thomasblankschein/fbh-monitor/docs/bilder/balkenclip.jpg

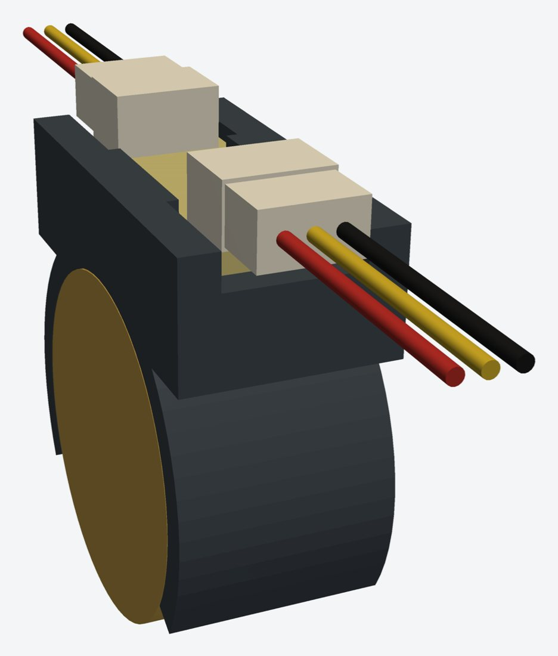
docs/bilder/balkenclip.jpg
