thomasblankschein/fbh-monitor/docs/bilder/basisplatine.jpg

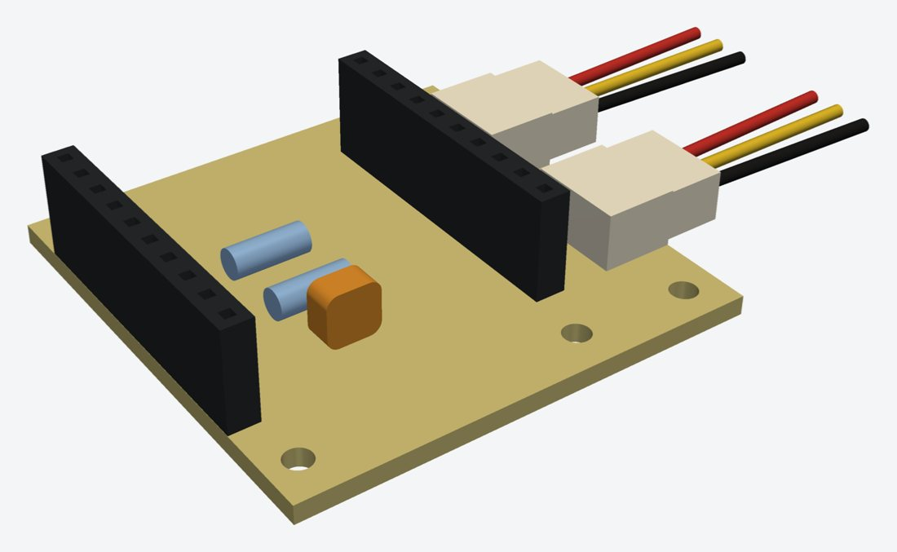
docs/bilder/basisplatine.jpg
