thomasblankschein/fbh-monitor/docs/bilder/druckbett.jpg

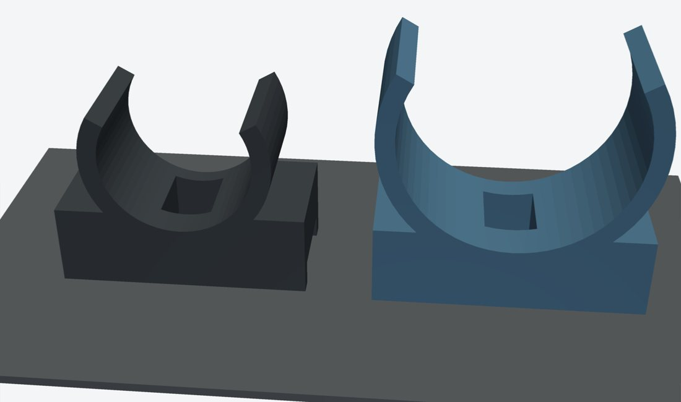
docs/bilder/druckbett.jpg
