thomasblankschein/fbh-monitor/docs/bilder/fuehlerknoten_unten.jpg

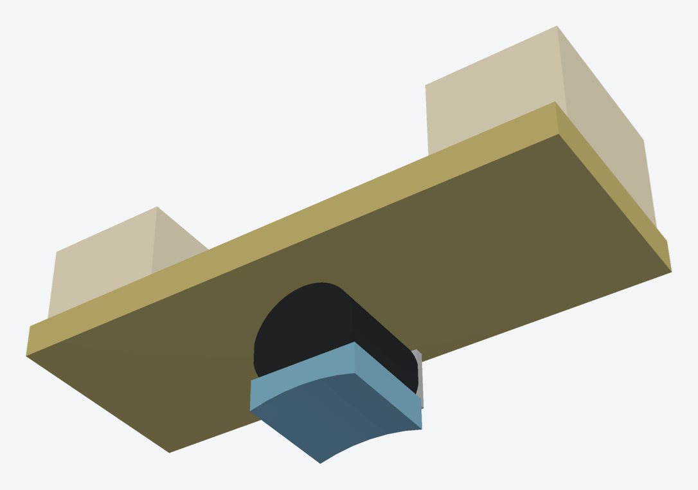
docs/bilder/fuehlerknoten_unten.jpg
