thomasblankschein/fbh-monitor/docs/bilder/kette.jpg

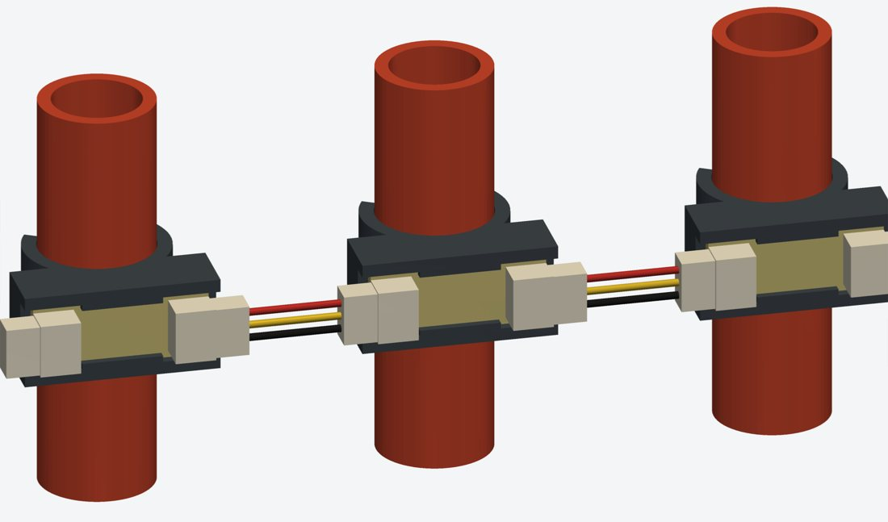
docs/bilder/kette.jpg
