thomasblankschein/fbh-monitor/docs/bilder/rohrclip_mit_knoten.jpg

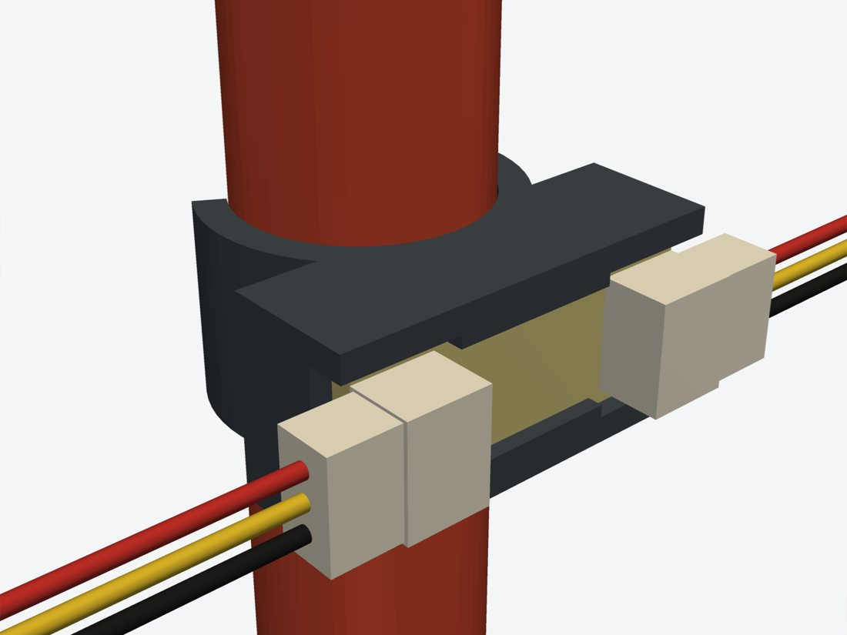
docs/bilder/rohrclip_mit_knoten.jpg
