thomasblankschein/fbh-monitor/docs/bilder/rohrclip_stirnseite.jpg

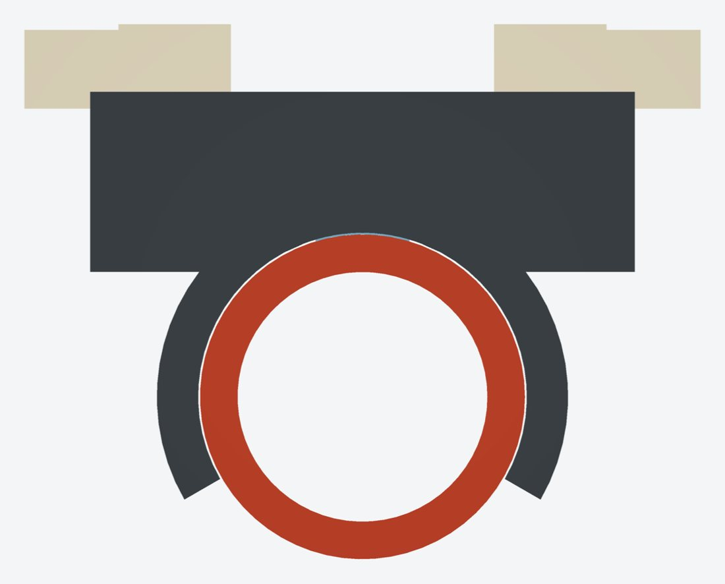
docs/bilder/rohrclip_stirnseite.jpg
