thomasblankschein/fbh-monitor/bestellung/digikey_warenkorb.csv

Menge | Digi-Key-Teilenummer | Hersteller-Teilenummer | Kundenreferenz
3 | 1188-ESP32-POE-ISO-ND | ESP32-POE-ISO | FBH Modul (2 + 1 Reserve/Test)
4 | 35-PRPC010SAAN-RC-ND | PRPC010SAAN-RC | FBH Stiftleiste 1x10
70 | 455-1720-ND | S3B-PH-K-S(LF)(SN) | FBH JST-PH Buchse gewinkelt
70 | 455-1126-ND | PHR-3 | FBH JST-PH Gehaeuse
200 | 455-2148-100-ND | SPH-002T-P0.5L | FBH Crimpkontakte (Streifen a 100)
