thomasblankschein/fbh-monitor/cad/export/modul_baugruppe.step

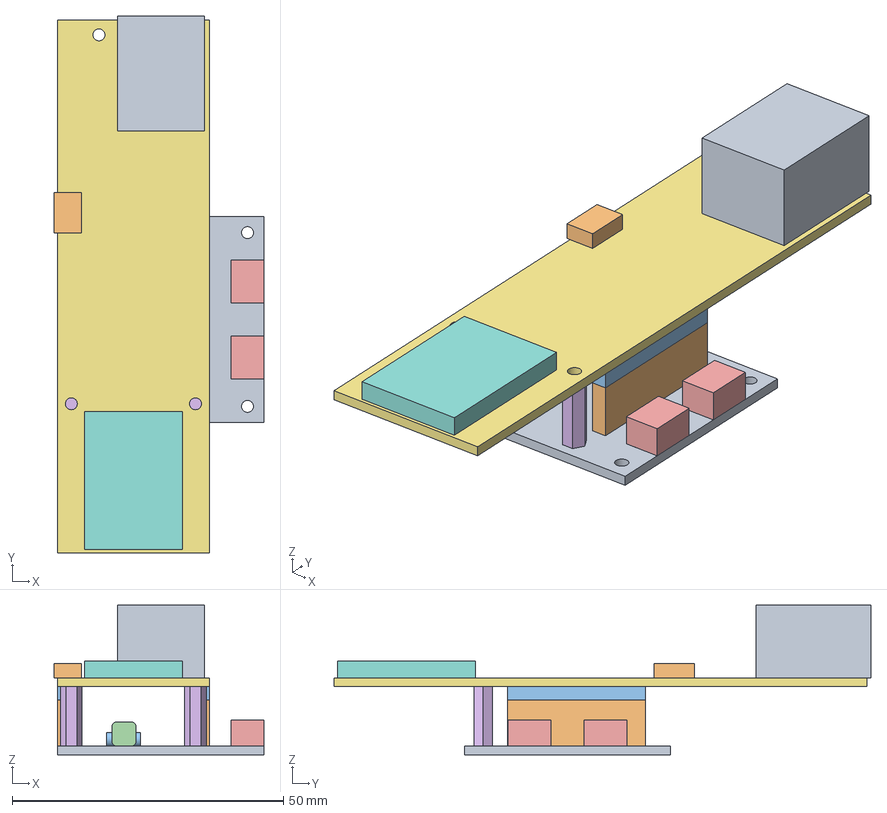
[picture p10: CAD file, 2026-10-25]
cad/export/modul_baugruppe.step
38.6 x 98.9 x 27.6 mm
