thomasblankschein/fbh-monitor/cad/export/fuehlerknoten.step

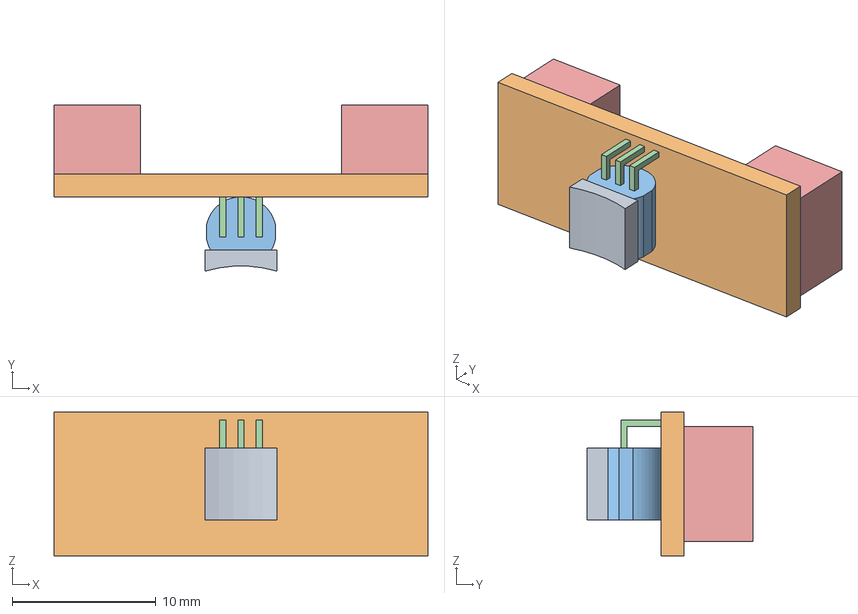
[picture p11: CAD file, 2026-10-25]
cad/export/fuehlerknoten.step
26.0 x 11.6 x 10.0 mm
