thomasblankschein/fbh-monitor/cad/export/rohrclip_balken_D26_7_druck.stl

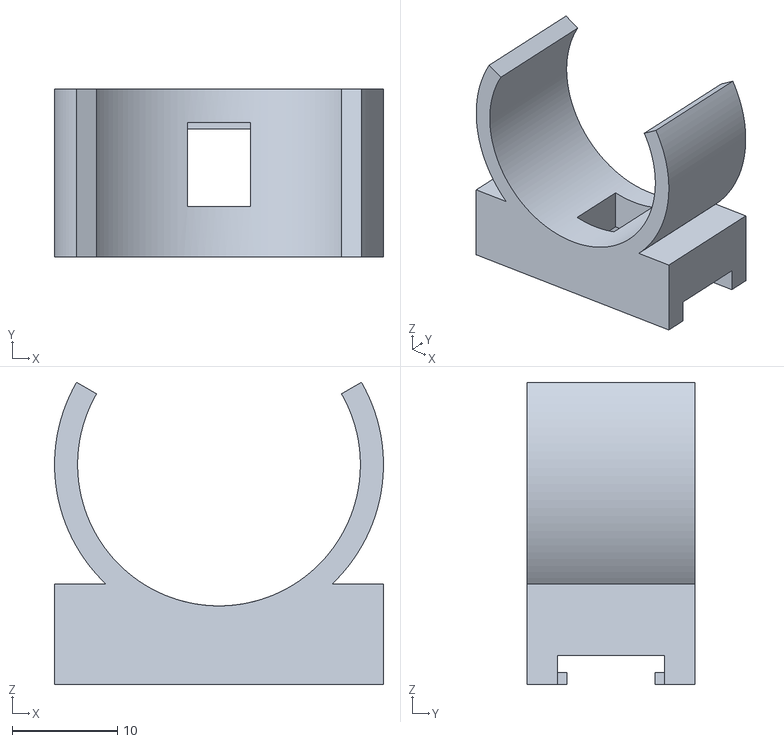
[picture p12: CAD file, 2026-10-25]
cad/export/rohrclip_balken_D26_7_druck.stl
31.3 x 16.0 x 28.8
