thomasblankschein/fbh-monitor/cad/export/rohrclip_abgang_D17_3.step

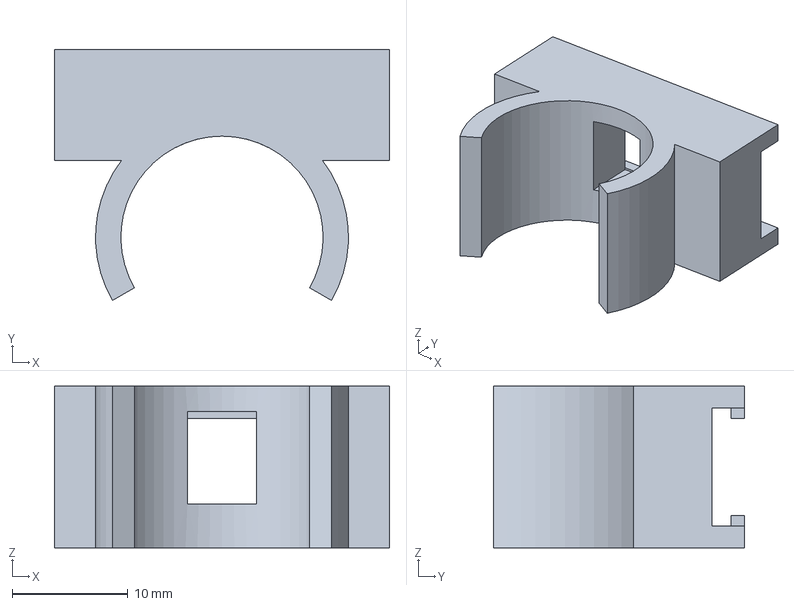
[picture p13: CAD file, 2026-10-25]
cad/export/rohrclip_abgang_D17_3.step
29.0 x 21.7 x 14.0 mm
