thomasblankschein/fbh-monitor/cad/export/distanzhuelse_11mm.stl

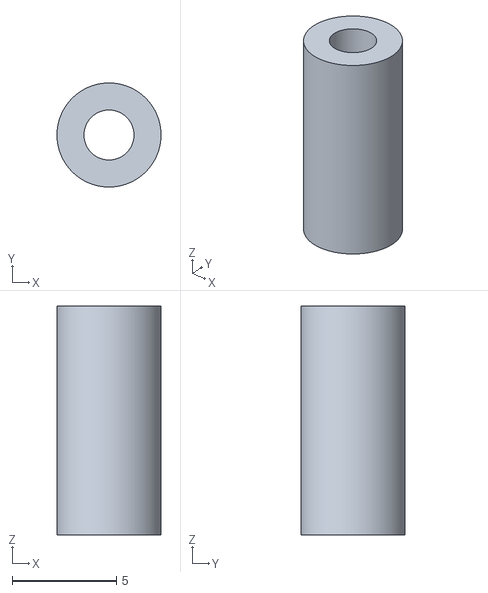
[picture p14: CAD file, 2026-10-25]
cad/export/distanzhuelse_11mm.stl
5.00 x 5.00 x 11.0
