thomasblankschein/fbh-monitor/(list of files, cad)

Other CAD files:
cad/export/rohrclip_balken_D26_7.step
cad/export/rohrclip_abgang_D17_3_druck.stl
