thomasblankschein/fbh-monitor/docs/bauanleitung.html

Maker-Projekt · KiCad · FreeCAD · ESPHome · Home Assistant

# FBH-Monitor

Vor- und Rücklauftemperatur jedes Fußbodenheizkreises messen und daraus erkennen, ob der Kreis durchflossen wird. Eigene Platinen, gedruckte Rohrclips und ein kompaktes Gehäuse pro Verteiler, versorgt über PoE.

Verteiler

EG + OG

Fühlerknoten je Verteiler

15

Gehäuse außen

≈ 44 × 104 × 36 mm

Versorgung

PoE 802.3af

## Konzept

Alles Aufwendige liefert das fertige Board: Ethernet, PoE mit galvanischer Trennung und den ESP32. Selbst gebaut werden nur einfache, einseitige Platinen, die sich gut ätzen oder fräsen lassen, sowie die Druckteile.

Basisplatine

38 × 38 mm, einseitig. Das Olimex ESP32-POE-ISO steckt über seine Steckleisten EXT1/EXT2 kopfüber auf ihr. Sie trägt die Pull-ups und zwei Buchsen für die Fühlerketten.

Fühlerknoten

10 × 26 mm, einseitig, sitzt direkt im Rohrclip. Ein DS18B20 im TO-92-Gehäuse und an beiden Enden eine gewinkelte JST-PH-Buchse, die Kabel laufen quer zum Rohr zum nächsten Knoten.

Kettenverkabelung

Statt 15 Kabeln sternförmig zum Gehäuse laufen zwei kurze Ketten am Verteiler entlang. Das spart Platz im Kasten und ist für 1-Wire die elektrisch bessere Topologie.

Rohrclips

Gedruckt aus PETG oder ASA, parametrisch für den Rohrdurchmesser. Sie drücken den Fühler mit Wärmeleitpaste ans Rohr und nehmen den Knoten auf.

Gehäuse

Gedruckt, konstruiert um die STEP-Daten des Olimex-Boards. Befestigung auf Hutschiene oder mit Kabelbindern an der Verteilerkonsole.

Eine komplett eigene Platine mit ESP32, Ethernet-PHY und PoE-Teil lohnt sich zum Selbstätzen nicht. Der PHY-Baustein sitzt im QFN-Gehäuse mit 0,5 mm Raster, die RMII-Leitungen laufen mit 50 MHz und das PoE-Netzteil braucht eine Trennung von 1500 V. Das gelingt zuverlässig nur mit gefertigten Mehrlagenplatinen.

## Ansichten

Gerendert aus den CAD-Modellen im Ordner cad. Das Olimex-Board ist vereinfacht: Umriss, Löcher, Steckleisten, Funkmodul, RJ45 und USB sitzen an den Positionen aus dem Olimex-Layout, kleine Bauteile fehlen.

Olimex-Board kopfüber auf der Basisplatine gesteckt, an der Seite zwei JST-Stecker mit Kabeln

R1 Modul: Olimex auf der Basisplatine, rechts die Ketten A und B.

Basisplatine mit zwei Buchsenleisten, zwei Widerständen, Kondensator und zwei gewinkelten JST-Buchsen

R2 Basisplatine 38 × 38 mm mit gesteckten Ketten.

Seitenansicht des Stapels aus Basisplatine, Steckleisten und Olimex-Board

R3 Seitenansicht: 11 mm Abstand zwischen den Platinen, eine gedruckte Distanzhülse pro Olimex-Loch.

Fühlerknoten von unten mit TO-92 und blauem Wärmeleitpad

R4 Fühlerknoten von unten: TO-92 mit dem Rücken an der Platine, darunter das Wärmeleitpad.

Schnitt durch Clip, Rohr, Wärmeleitpad, TO-92 und Platine

R5 Schnitt in Rohrmitte: Rohr, Pad (blau), TO-92, Knotenplatine. Die Rastnasen drücken die Platine nach unten und das Pad zusammen.

Rohrclip auf rotem Heizungsrohr mit eingesetztem Fühlerknoten und Kabeln

R6 Abgangsclip auf Rohr Ø 17,3 mm mit eingerastetem Knoten.

Rohrclip in Blickrichtung des Rohrs mit Öffnung nach unten

R7 Blick entlang des Rohrs: 120° Öffnung, der Clip wird etwa 1 mm je Seite aufgebogen.

Balkenclip auf dem runden Abschnitt des Vorlaufbalkens

R8 Balkenclip auf dem runden Abschnitt Ø 26,7 mm, volle 16 mm breit.

Beide Clips mit der Rastnasen-Seite nach unten auf dem Druckbett

R9 Druckausrichtung: Rastnasen-Seite aufs Bett, kein Stützmaterial nötig.

Drei Rohre im Abstand 50 mm mit Clips, Knoten und verbindenden Kabeln

R10 Kette an drei Rohren im Abstand 50 mm. Zwischen zwei Steckern bleiben nur etwa 14 mm, die Segmentkabel brauchen daher eine kleine Schlaufe.

## Systemübersicht

Abb. 1 Topologie. Jeder Verteiler ist ein eigenes ESPHome-Gerät mit identischer Hardware.

## Fühlerketten am Verteiler

Kette A beginnt am Referenzfühler auf dem Vorlaufbalken und läuft dann über alle Vorläufe. Kette B läuft über alle Rückläufe. Zwischen zwei Knoten liegt ein kurzes Kabel, etwas länger als der Abstand der Abgänge (meist 50 mm, bitte nachmessen).

Abb. 2 Kette A (rot, 8 Knoten) und Kette B (blau, 7 Knoten). Jeder Knoten sitzt in einem Rohrclip.

- Vorlauf: Knoten 3–5 cm unterhalb der Verschraubung. Näher am Messing würde die Wärme vom Balken einen geschlossenen Kreis warm erscheinen lassen.
- Rücklauf: direkt unter der Verschraubung. Dort gibt es diesen Effekt nicht, also gilt hier: möglichst nah am Verteiler.
- Die Reihenfolge in der Kette spielt für die Software keine Rolle, jeder Fühler wird über seine eindeutige Adresse angesprochen.

### Kettenverkabelung

Variante | Aufbau | Bewertung
JST-PH-Segmenteempfohlen | Je Knoten zwei gewinkelte Buchsen. Zwischen zwei Knoten ein Kabel mit zwei PHR-3-Steckern, Pins 1:1 durchverbunden. | Flach, verriegelnd, jedes Segment einzeln tauschbar. Braucht eine Crimpzange oder fertige Kabel.
Flachband mit Schneidklemmen | Ein durchgehendes 6-adriges Flachbandkabel je Kette. An jeder Knotenposition wird ein 2 × 3-Pfostenstecker aufgepresst, auf dem Knoten sitzt ein Wannenstecker. | Kein Crimpen, ein Kabel pro Kette. Der Knoten wird aber gut 10 mm höher und die Steckerpositionen sind nach dem Pressen fest.
Direkt verlötet | Litze direkt auf Lötpads der Knoten. | Am kleinsten, aber nicht wartbar. Ein defekter Fühler bedeutet Lötarbeit am Verteiler.

- Segmentlänge: etwa 80 mm bei 50 mm Abgangsabstand. Die Schlaufe gleicht Toleranzen aus und lässt sich unter das Armaflex-Band legen.
- Zuleitung: vom Modul zum ersten Knoten jeder Kette nach Bedarf, typisch 30–60 cm.
- Kettenende: Die freie Buchse am letzten Knoten bleibt einfach offen, ein Abschlusswiderstand ist nicht nötig.

Jedes Kabel vor dem Einstecken mit dem Multimeter prüfen: Pin 1 muss auf Pin 1 gehen. Fertige JST-Kabel werden oft gedreht verkauft. Ein gedrehtes Kabel vertauscht GND und VDD, das zerstört den Fühler.

## Schaltplan Basisplatine

Abb. 3 Basisplatine. Pinbelegung von EXT1/EXT2 aus dem KiCad-Layout von Olimex (Rev. O) übernommen.

- Die Pin-Reihenfolge 1 GND · 2 DQ · 3 VDD gilt an allen Buchsen und entspricht der Belegung des DS18B20 im TO-92-Gehäuse. Leiterbahnen laufen dadurch auf allen Platinen gerade durch.
- 4,7 kΩ reichen bei zwei kurzen Ketten unter 2 m. Falls einzelne Fühler sporadisch fehlen, auf 2,2 kΩ wechseln.
- Optional pro Kette ein Footprint für eine ESD-Schutzdiode (z. B. SOD-323) zwischen DQ und GND vorsehen, bestückt wird sie nur bei Bedarf.

## Mechanik Basisplatine

Olimex sieht die Steckleisten EXT1/EXT2 auf der Unterseite vor. Stiftleisten werden also von oben eingesteckt und unten herausstehend verlötet. Das Board steckt dann mit der Bauteilseite nach oben in die Buchsenleisten der Basisplatine.

Abb. 4 Maße in mm, bezogen auf das Antennenende des Olimex-Boards. Roter Punkt = Pin 1. Löcher: Olimex Ø 2,2 mm, Basisplatine für M2.

Steckleisten

EXT1 1,29 mm von der linken Kante, EXT2 1,31 mm von der rechten Kante, Abstand 25,40 mm. Pin 1 liegt 33,22 mm vom Antennenende, Pin 10 bei 56,08 mm.

Montagelöcher Olimex

Zwei Löcher Ø 2,2 mm bei 27,48 mm vom Antennenende, 2,56 mm von links und 2,58 mm von rechts. Diese übernimmt die Basisplatine, verbunden wird mit M2-Schraube und gedruckter Distanzhülse. Ein drittes Loch sitzt beim RJ45 (7,64 / 95,42 mm) und stützt das Board im Gehäuse.

Basisplatine

38 × 38 mm, Längsbereich 24–62 mm. Rechts 10 mm Überstand für J1 und J2, die Kabel gehen seitlich heraus. Zwei weitere M2-Löcher zur Befestigung im Gehäuse.

Bauhöhe

Mit Standard-Buchsenleisten (8,5 mm) etwa 11 mm Abstand zwischen den Platinen. Auf der Olimex-Unterseite sitzen dort nur flache Bauteile, das höchste ist eine Diode mit 2,3 mm.

Das Board gibt es auch als WROVER-Variante. Dort liegt der Ethernet-Takt auf GPIO0 statt GPIO17, und GPIO33 ist belegt. Für dieses Konzept unbedingt die WROOM-Variante kaufen.

## Fühlerknoten und Rohrclip

Abb. 5 Fühlerknoten. Links Schaltplan, Mitte Platine, rechts schematischer Querschnitt: Clip auf dem Rohr, darüber der Knoten, außen herum Armaflex-Band. Die genaue Form zeigen R5 bis R7.

Clip

C-Form mit 120° Öffnung, 2,2 mm Wandstärke, 0,1 mm radiales Spiel, 14 mm lang (Balken 16 mm). Zwei Varianten nach deinen Maßen: Abgang Ø 17,3 mm (29 × 22 × 14 mm, etwa 4,3 g) und Balken Ø 26,7 mm (31 × 29 × 16 mm, etwa 6 g).

Druck

Mit der Rastnasen-Seite aufs Bett legen, so sind die STL-Dateien bereits ausgerichtet. Ohne Stützmaterial, Brim empfohlen, weil die Auflagefläche klein ist. Erst einen Clip testen: Sitzt er zu stramm, im Skript das Spiel auf 0,2 mm erhöhen.

Aufnahme

Zwei Wände mit Rastnasen halten die Knotenplatine. Die Nasen drücken die Platine nach unten, die Platine drückt den TO-92 und der TO-92 das Pad durch ein Fenster im Sattel auf das Rohr. Ein Deckel ist nicht nötig. Die Kabel gehen quer zum Rohr seitlich heraus.

Wärmeübergang

Silikon-Wärmeleitpad 1,5 mm, 5 × 5 mm, weich (Shore 00 ≤ 50), 3–6 W/mK. Der Clip ist so bemessen, dass das Pad am Rohrscheitel auf 1,1 mm zusammengedrückt wird (etwa 27 %). An den Rändern des Sensors bleibt es durch die Rohrkrümmung noch leicht angedrückt. Das Pad gleicht Toleranzen von Druck und Rohr aus und ist zugleich die Feder für den Anpressdruck.

Befestigung TO-92

Der Rücken des TO-92 liegt direkt an der Platinenunterseite und wird mit einem Tropfen 2K-Epoxid fixiert. Die Anpresskraft geht so über den Sensorkörper, nicht über die Lötstellen.

Variante Balken

Sitzt auf dem runden Abschnitt (Ø 26,7 mm, 16 mm breit). Die Kabel laufen quer zur Balkenachse, also bei waagerechtem Balken nach oben und unten.

Material

PETG oder ASA. PLA wird im warmen Verteilerkasten auf Dauer weich und verliert die Klemmkraft.

## Gehäuse

Innenmaß

etwa 40 × 100 × 32 mm, außen etwa 44 × 104 × 36 mm bei 2 mm Wandstärke.

Öffnungen

RJ45 an der Stirnseite, Micro-USB an der linken Längsseite (nur zum ersten Flashen), J1 und J2 an der rechten Längsseite.

Befestigung

Basisplatine mit zwei M2-Schrauben auf Domen im Boden. Olimex mit M2-Schrauben und Distanzhülsen auf der Basisplatine, zusätzlich eine Stütze unter dem Loch beim RJ45, damit beim Einstecken des Patchkabels nichts auf die Steckleisten drückt.

Montage

Hutschienen-Rastfuß (TS35) oder zwei Schlitze für Kabelbinder an der Verteilerkonsole.

Wärme

Das Modul nimmt unter 2 W auf. Ein paar Lüftungsschlitze im Deckel genügen.

Am genauesten wird das Gehäuse, wenn du Olimex' KiCad-Dateien (GitHub, Ordner HARDWARE, Rev. O) öffnest, daraus ein STEP-Modell exportierst und dieses in FreeCAD als Referenz einsetzt. So stimmen RJ45, USB und Löcher ohne Nachmessen.

## Fertigungshinweise KiCad

- Beide Platinen einseitig, Kupfer unten. Leiterbahnen mindestens 0,6 mm, Abstände mindestens 0,4 mm. Das ist zum Ätzen und Fräsen unkritisch.
- Pads für Steckverbinder mindestens 1,8 mm Durchmesser, Bohrungen 0,8 mm für Bauteile und 1,0 mm für Stift- und Buchsenleisten.
- Die Basisplatine hat nur vier Netze und lässt sich ohne Brücken entflechten. Die Lage der Buchsenleisten aus Abb. 4 als Raster mit Ursprung am Antennenende anlegen.
- Am Knoten liegt der TO-92 auf der Kupferseite. Die Pads dafür als SMD-Pads (etwa 1,2 × 2,5 mm) anlegen und die gebogenen Beinchen flach auflöten. Der Sensorrücken liegt ohne Spalt an der Platine.
- Ein Nutzen aus 15 Knoten plus Basisplatine braucht etwa 60 × 100 mm. Eine Europakarte reicht für beide Verteiler.
- Nach dem Ätzen Lötstopplack oder Schutzlack aufbringen, weil im Verteilerkasten Kondenswasser auftreten kann.

## Bauteilliste

Mengen pro Verteiler und für beide zusammen, mit etwas Reserve. Die Datei digikey_warenkorb.csv enthält alle Digi-Key-Positionen für beide Verteiler und lässt sich im Digi-Key-Warenkorb hochladen. Eine Crimpzange für JST-PH wird zusätzlich gebraucht.

Bauteil | Hersteller-Nr. und Spezifikation | Digi-Key | je Verteiler | gesamt
Modul
Olimex ESP32-POE-ISO | Olimex ESP32-POE-ISO, WROOM-Variante, nicht „-WROVER“Galvanisch getrennt, darf gleichzeitig an USB und PoE | 1188-ESP32-POE-ISO-ND | 1 | 2
Stiftleiste 1 × 10 | Sullins PRPC010SAAN-RC, 2,54 mm, an Olimex-Unterseite löten | 35-PRPC010SAAN-RC-ND | 2 | 4
Buchsenleiste 1 × 10 | Sullins PPTC101LFBN-RC, 2,54 mm, 8,5 mm hoch | S7008-ND | 2 | 4
Widerstand 4,7 kΩ | Stackpole CF14JT4K70, 1/4 W, bedrahtet 0207 | CF14JT4K70CT-ND | 2 | 4
Kondensator 100 nF | KEMET C1206C104K5RACTU, 1206, X7R, 50 V | 399-C1206C104K5RACTUCT-ND | 1 | 2
JST-PH-Buchse gewinkelt | JST S3B-PH-K-S(LF)(SN), 3-polig | 455-1720-ND | 2 | 4
Distanzhülse | gedruckt, Ø 5 mm, Bohrung 2,4 mm, 11 mm hochDatei distanzhuelse_11mm.stl | – | 2 | 4
Schraube mit Mutter | M2 × 16, Olimex auf Basisplatine | Normteil | 2 | 4
Schraube | M2 × 6, Basisplatine im Gehäuse | Normteil | 2 | 4
Fühlerknoten
Temperaturfühler | Analog Devices DS18B20+, TO-92Beim Distributor kaufen, auf Marktplätzen sind Fälschungen häufig | DS18B20+-ND | 15 + 1 | 32
JST-PH-Buchse gewinkelt | JST S3B-PH-K-S(LF)(SN), 3-polig | 455-1720-ND | 30 | 60
Kondensator 100 nF | KEMET C1206C104K5RACTU, optional | 399-C1206C104K5RACTUCT-ND | 15 | 30
Wärmeleitpad | t-Global TG-A4500-100-100-1.5, 1,5 mm, 4,5 W/mK, Shore 00 50 ± 15Bogen 100 × 100 mm, daraus 5 × 5 mm schneiden | 1168-TG-A4500-100-100-1.5-ND | 15 | 1 Bogen
Kabel
JST-PH-Gehäuse | JST PHR-3, 3-polig | 455-1126-ND | 30 + 4 | 68
Crimpkontakte | JST SPH-002T-P0.5L, AWG 24–28Isolation 0,8–1,5 mm, passend für Alpha Wire 3049 | 455-2148-100-ND | 100 | 200
Litze schwarz, gelb, rot | Einzelader 0,13–0,14 mm² (26 AWG), Außendurchmesser 0,8–1,5 mm, z. B. Alpha Wire 3049Nicht über Digi-Key: dort nur 30-m-Spulen, gebraucht werden etwa 6 m je Farbe | Elektronikhandel | 3 m je Farbe | 6 m je Farbe
Fertigung und Montage
Basismaterial | FR4 einseitig, 1,6 mm, Europakarte 100 × 160 mm | – | – | 1
Filament | PETG oder ASA, Gehäuse, Clips, Distanzhülsen | – | ≈ 80 g | ≈ 160 g
2K-Epoxid | Zum Fixieren des TO-92 an der Platine | – | – | 1
Dämmband | Armaflex-Tape, 3 mm × 50 mm | – | – | 1 Rolle
Patchkabel | Cat 6, 0,5–1 m | – | 1 | 2
PoE-Port | Switch oder Injektor nach IEEE 802.3afPassives PoE funktioniert nicht | – | 1 | 2

Alle Nummern und Mengen wurden am 25.10.2026 im Digi-Key-Warenkorb geprüft, alle Positionen waren sofort lieferbar. Die Crimpkontakte gibt es als Streifen zu 100 Stück, die Kondensatoren sind bei 50 Stück günstiger als bei 35.

Alternativ gibt es alle Teile außer dem Olimex-Board bei reichelt (bestellung/reichelt_warenkorb.csv, etwa 88 € inkl. MwSt. plus Versand). Dort waren am 25.10.2026 nur 37 PHR-3-Gehäuse verfügbar; der Rest muss nachbestellt werden. Die gelbe Litze gibt es nicht als 10-m-Ring, DQ ist dort orange. Das Olimex-Board direkt bei Olimex oder bei Digi-Key bestellen.

## Inbetriebnahme

### Platinen fertigen und bestücken

1. Basisplatine und 15 Knoten ätzen oder fräsen, lackieren, bestücken. Den TO-92 mit dem Rücken an die Platine legen, Beinchen verlöten und mit einem Tropfen Epoxid fixieren. Stiftleisten von oben in EXT1 und EXT2 des Olimex stecken und auf der Unterseite herausstehend verlöten. Vor dem ersten Einschalten 3,3 V gegen GND auf Kurzschluss prüfen.

### Kabel konfektionieren

2. Je Verteiler 13 Segmente von etwa 80 mm und zwei Zuleitungen vom Modul zum ersten Knoten crimpen, Pins 1:1 durchverbunden. Jedes Kabel mit dem Multimeter prüfen.

### Firmware flashen

3. Den Ordner esphome ins ESPHome-Dashboard kopieren, Schlüssel in secrets.yaml eintragen und fbh-eg.yaml erstmals per USB flashen. Danach läuft alles per OTA.

### Adressen auslesen

4. Am Tisch jeweils einen Knoten an J1 stecken und neu starten. Im Log erscheint unter one_wire seine Adresse. Knoten beschriften (z. B. „EG K3 RL“) und die Adresse in die YAML-Datei eintragen.

### Kalibrieren

5. Alle Knoten eines Verteilers in einen Gefrierbeutel legen, Luft herausdrücken und den Beutel 15 Minuten in ein Wasserbad von etwa 35 °C hängen. Dazu alle Knoten zu einer Kette verbinden. Die Abweichung jedes Fühlers vom Mittelwert kommt als vl_offset bzw. rl_offset in die YAML-Datei.

### Montieren

6. Pad mittig auf das Rohr legen, Clip aufschnappen, Knoten unter die Rastnasen drücken und die Ketten stecken. Jeden Clip und je 3 cm Rohr darüber und darunter mit zwei Lagen Armaflex-Band überwickeln.

### Home Assistant einrichten

7. Das Gerät wird automatisch gefunden. Package und Jinja-Datei kopieren, in fbh.jinja die Entitäten der Stellantriebe eintragen und die Konfiguration neu laden.

### Schwellwerte einmessen

8. Zwei bis drei Heiztage die Verläufe beobachten und die drei Schwellwerte auf der Geräteseite unter „Konfiguration“ anpassen.

## So wird der Durchfluss erkannt

Ein Kreis gilt als durchflossen, wenn alle drei Bedingungen erfüllt sind. Erst wenn der Zustand 3 Minuten stabil ist, wird er übernommen.

Bedingung | Bedeutung | Startwert
Balken-VL > Heizbetrieb ab Vorlauf | Die Anlage heizt überhaupt. Ohne Heizbetrieb gilt jeder Kreis als „aus“, so gibt es im Sommer keine Fehlalarme. | 25 °C
Balken-VL − Kreis-VL ≤ Schwelle VL-Abfall | Warmes Wasser kommt im Kreis an. | 2,0 K
Kreis-VL − Kreis-RL ≥ Mindestspreizung | Der Kreis gibt Wärme an den Estrich ab. | 1,0 K

Home Assistant vergleicht diesen Ist-Zustand mit dem Stellantrieb. Weichen beide länger als 20 Minuten voneinander ab, meldet binary_sensor.fbh_kreisfehler den betroffenen Kreis, etwa „Ventil offen, aber kein Durchfluss“.

## Dateien

esphome/fbh-eg.yamlGerät Erdgeschoss mit Fühleradressen und Offsets

esphome/fbh-og.yamlGerät Obergeschoss, gleicher Aufbau

esphome/common/fbh-basis.yamlBoard, Ethernet, beide Ketten, Schwellwerte, Heizbetrieb

esphome/common/fbh-kreis.yamlVorlage für einen Kreis: VL, RL, Spreizung, Durchfluss

esphome/secrets.yamlPlatzhalter für die API-Schlüssel

homeassistant/packages/fbh_monitor.yamlKreisfehler, Übertemperatur, Sensorausfall, aktive Kreise, Benachrichtigung

homeassistant/custom_templates/fbh.jinjaZuordnung Kreis zu Stellantrieb und Soll/Ist-Vergleich

homeassistant/dashboard-karte.yamlFertige Dashboard-Karte für das EG

digikey_warenkorb.csvAlle Digi-Key-Positionen für beide Verteiler zum Hochladen in den Warenkorb

cad/export/distanzhuelse_11mm.stlDistanzhülse zwischen Basisplatine und Olimex

cad/fbh_cad.pyParametrisches CadQuery-Skript für Clip, Knoten und Modul

cad/export/rohrclip_abgang_D17_3*.step / _druck.stlClip für die Abgänge Ø 17,3 mm, STL druckfertig ausgerichtet

cad/export/rohrclip_balken_D26_7*.step / _druck.stlClip für den Vorlaufbalken Ø 26,7 mm

cad/export/fuehlerknoten.stepKnotenplatine mit Bauteilen als Referenz

cad/export/modul_baugruppe.stepBasisplatine mit vereinfachtem Olimex, Grundlage für das Gehäuse

Für das Package muss in der configuration.yaml stehen:

homeassistant:
  packages: !include_dir_named packages
