thomasblankschein/fbh-monitor/docs/bilder/gesamtaufbau_seite.jpg

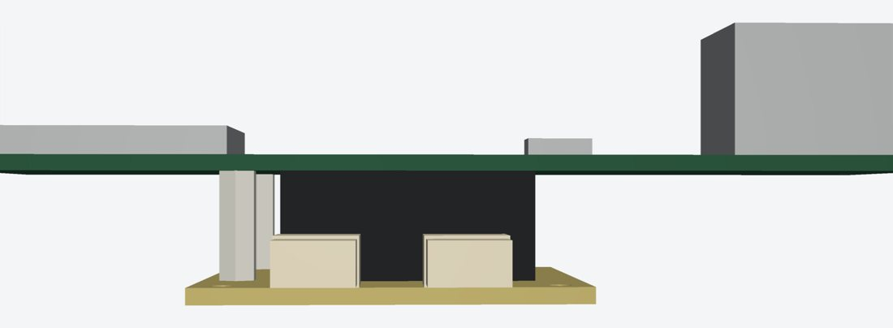
docs/bilder/gesamtaufbau_seite.jpg
