thomasblankschein/fbh-monitor/(commit log)

2026-10-25 Erster Stand FBH-Monitor
    - ESPHome-Konfiguration für Verteiler EG/OG mit je 15 Fühlern
    - Home-Assistant-Package: Kreisfehler, Übertemperatur, Sensorausfall
    - Parametrische CAD-Modelle (CadQuery), Rohrclips 17,3/26,7 mm, Distanzhülse
    - Bauanleitung mit Schaltplänen, Renderings und Bauteilliste
    - Digi-Key-Warenkorb
    Claude-Session: https://claude.ai/code/session_019FQWmirPuQbkQeJvNdawpb
    [digikey_warenkorb.csv, distanzhuelse_11mm.stl, fuehlerknoten.step, modul_baugruppe.step, rohrclip_abgang_D17_3.step, rohrclip_abgang_D17_3_druck.stl, rohrclip_balken_D26_7.step, rohrclip_balken_D26_7_druck.stl]
2026-10-25 Litze Alpha Wire 3049 mit Digi-Key-Nummern ergänzt
    26 AWG, Isolation 1,3 mm, passend für JST SPH-002T-P0.5L.
    Schwarz (GND), gelb (DQ), rot (VDD) je eine 30-m-Spule.
    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
    [digikey_warenkorb.csv]
2026-10-25 Digi-Key-Nummern nach Warenkorbprüfung aktualisiert
    - Stiftleiste: 35-PRPC010SAAN-RC-ND (neue Nummer)
    - Kondensator: 399-C1206C104K5RACTUCT-ND, 50 Stück (günstiger als 35)
    - Crimpkontakte: 455-2148-100-ND, Streifen à 100 (455-2148-1-ND ist ausgelaufen)
    - Alle Positionen am 25.10.2026 sofort lieferbar
    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
    [digikey_warenkorb.csv]
2026-10-25 Litze aus dem Digi-Key-Warenkorb genommen
    Bezug lokal; Anforderung: 26 AWG, Außendurchmesser 0,8–1,5 mm.
    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
    [digikey_warenkorb.csv]
2026-10-25 Alternativer Warenkorb für reichelt.de
    Alle Teile außer Olimex ESP32-POE-ISO, Stand 25.10.2026.
    PHR-3 nur 37 Stück verfügbar, DQ-Litze orange statt gelb.
    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
    [reichelt_warenkorb.csv]
2026-10-25 Bestellung auf Digi-Key und reichelt aufgeteilt
    Digi-Key: Olimex (3), Stiftleisten, JST-PH Buchsen, Gehäuse, Crimpkontakte.
    reichelt: Buchsenleisten, DS18B20, Widerstände, Kondensatoren, Wärmeleitpad, Litze.
    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
    [digikey_warenkorb.csv, reichelt_warenkorb.csv]
2026-10-25 reichelt-Liste: Artikelnummern mit Komma korrekt quotiert
    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
    [reichelt_warenkorb.csv]
2026-10-25 CLAUDE.md mit Projektkontext, README aktualisiert, Render-Skript
    - CLAUDE.md: Stand, Entscheidungen, Maße, Pinbelegung, Bestellung, nächste Schritte
    - README: Bestellung, Struktur, Status
    - cad/render_ansichten.py: Renderings reproduzierbar (Ausgabe nicht versioniert)
    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
